xenz25/IRRemoteControlledACPorts-HomeAutomation/README.md

# IRRemoteControlledACPorts-HomeAutomation
A Home Automation Project Remote Controlled AC High Voltage Extension Ports. Created for my Feedback and Control System Course.
