xenz25/IRRemoteControlledACPorts-HomeAutomation/Home Automation/Schematic_Home Automation Schematic_2021-02-15_14-42-45.pdf

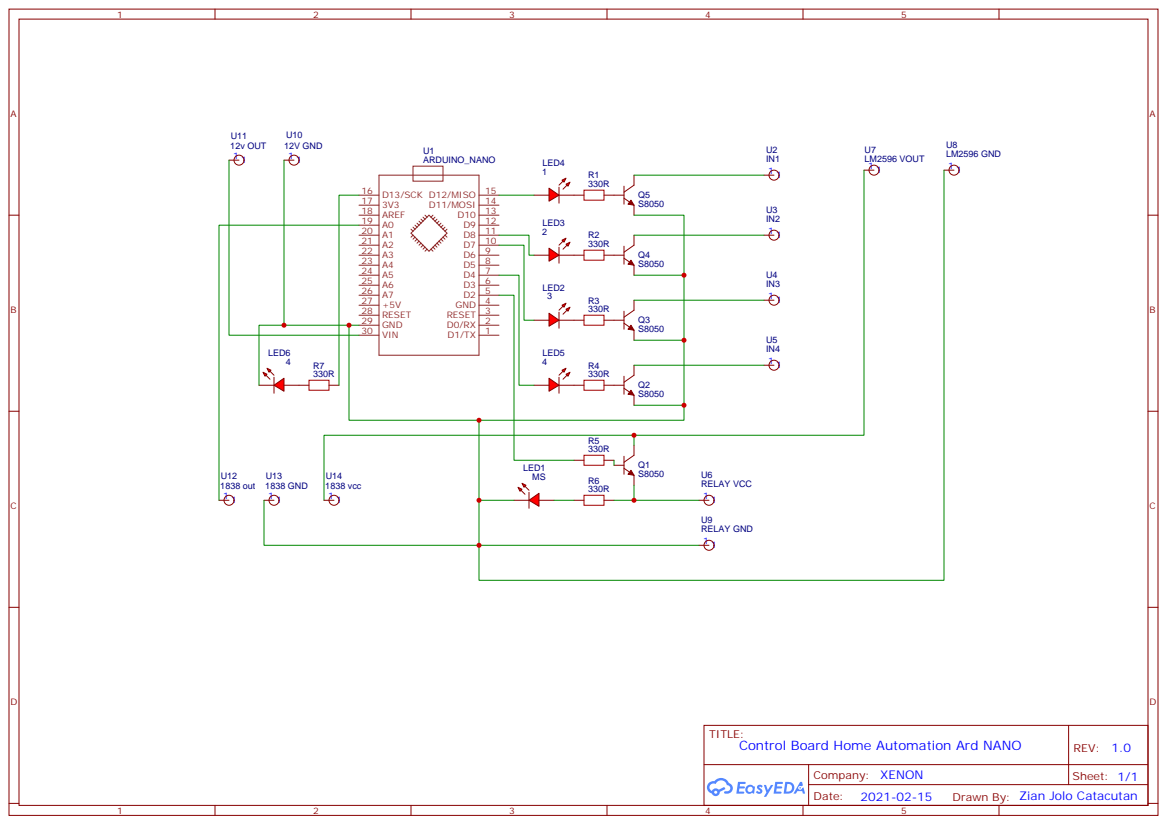
[picture p47: page 1]
